Ljetnaveic/lcn30-drg2-dn40/files/renders/render_3d_southeast.png

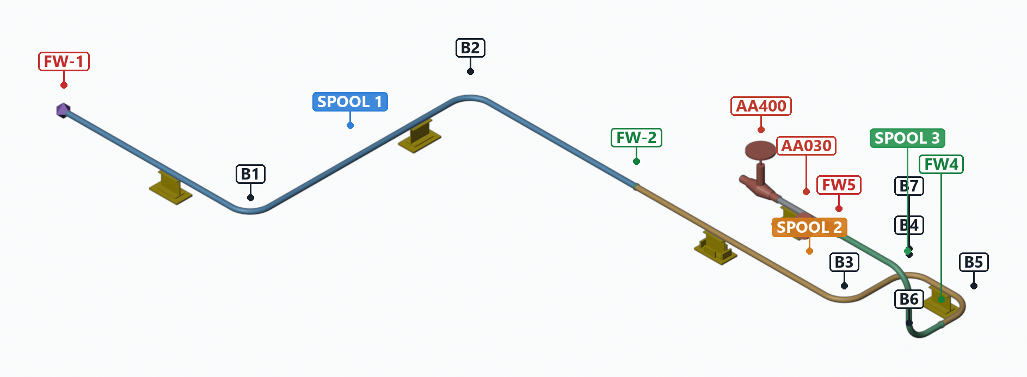
files/renders/render_3d_southeast.png
