Ljetnaveic/lcn30-drg2-dn40/files/renders/render_3d_southwest.png

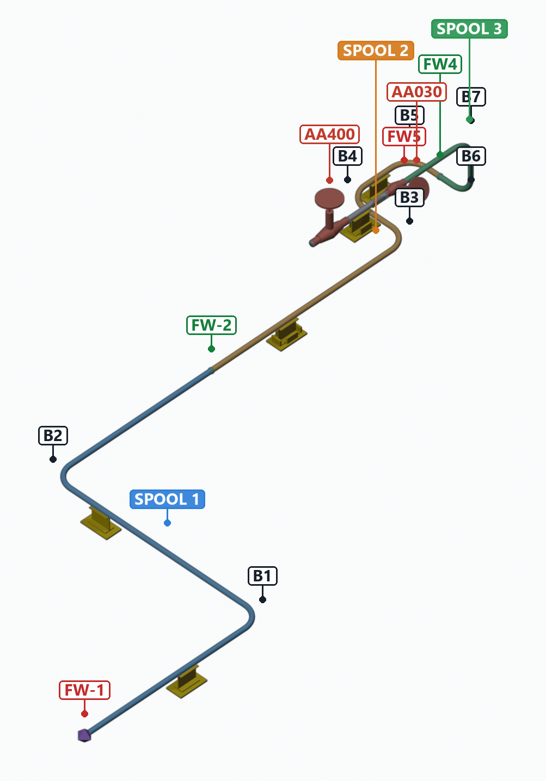
files/renders/render_3d_southwest.png
