Ljetnaveic/lcn30-drg2-dn40/files/renders/render_context_drg1.png

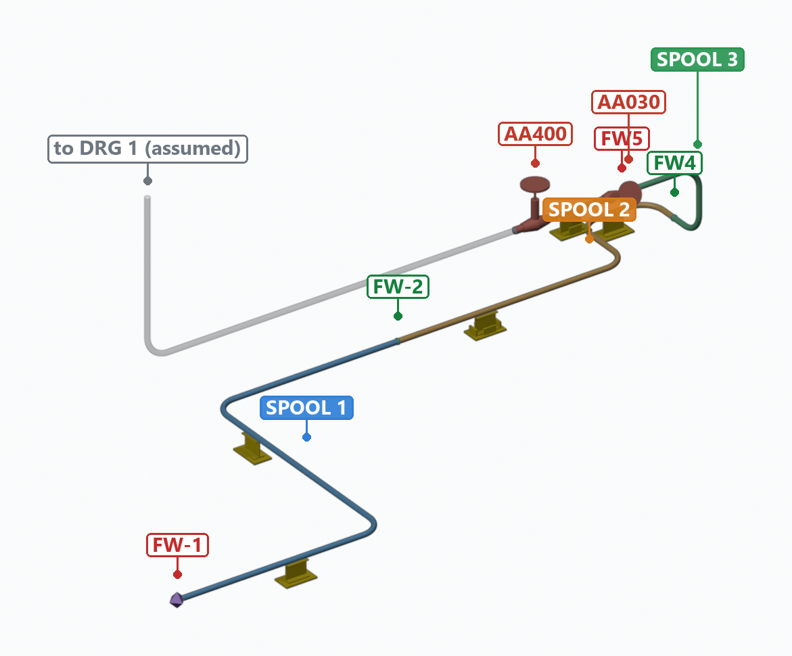
files/renders/render_context_drg1.png
