Ljetnaveic/lcn30-drg2-dn40/files/renders/render_plan_top.png

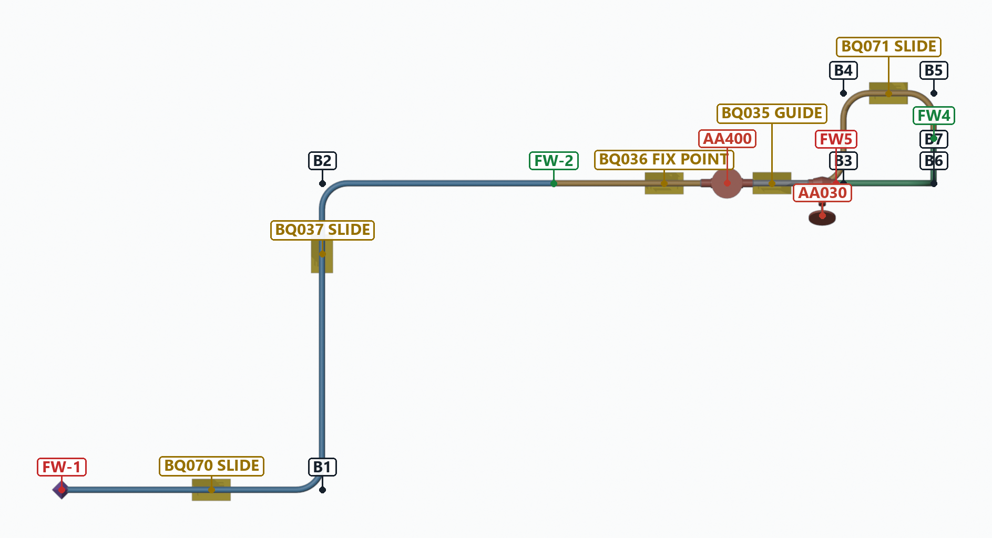
files/renders/render_plan_top.png
