Ljetnaveic/lcn30-drg2-dn40/files/renders/render_valves_loop.png

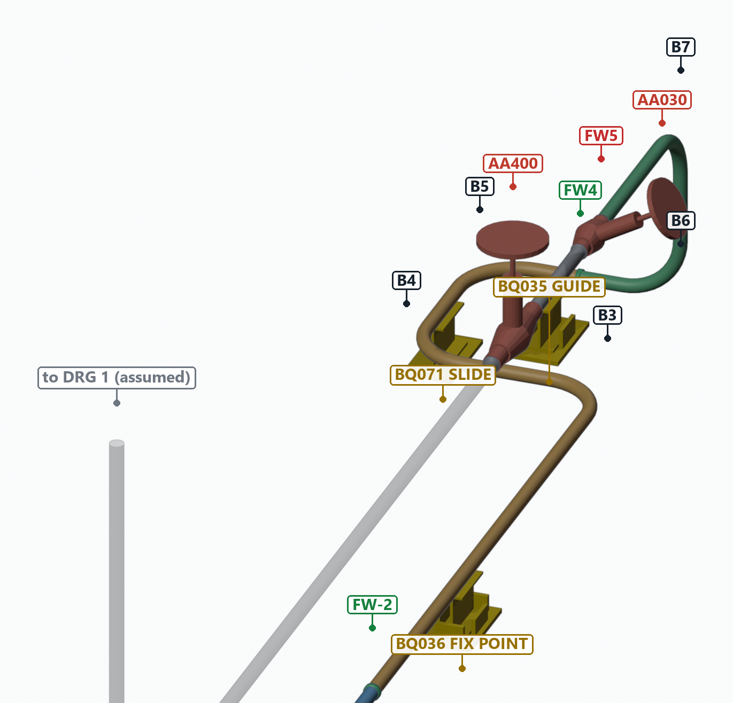
files/renders/render_valves_loop.png
