Ljetnaveic/lcn30-drg2-dn40/files/1LCN30_DRG2_DN40_BOM.csv

item | desc | qty | note
1 | Pipe DN40 (OD 48.3), class ECJB_TBY - spools 1-3 (developed) | 11.36 m | wall per class ECJB_TBY
2 | Pipe DN40 - piece between valves (iso ref <8>) | 0.44 m | 435 mm
3 | Pipe bend 90 deg, R = 200 mm (bent on pipe) | 7 pcs | B1-B7
4 | Valve 1LCN30AA030 (iso item 2), F-F 210, spindle H 60 deg | 1 pc | free issue / per valve list
5 | Valve 1LCN30AA400 (iso item 3), F-F 400, spindle H 0 deg, 30 deg BW ends | 1 pc | free issue / per valve list
6 | Support S4 SLIDE (BQ070, BQ037, BQ071) | 3 pcs | TC021-AFR-...-SU
7 | Support S4/7/6/6/6 FIX POINT (BQ036) | 1 pc | TC021-AFR-1LCN30BQ036-SU
8 | Support S4/5/6/6/6 GUIDE (BQ035) | 1 pc | TC021-AFR-1LCN30BQ035-SU
9 | Field welds FW-1, FW-2, FW4, FW5 (+ valve welds VW-1..3) | 4 + 3 | FW-2, FW4 welded
10 | Insulation 100 mm (density 0 per sheet) | 11.8 m | excl. valves
