Ljetnaveic/lcn30-drg2-dn40/files/1LCN30_DRG2_DN40_3D_Model.obj

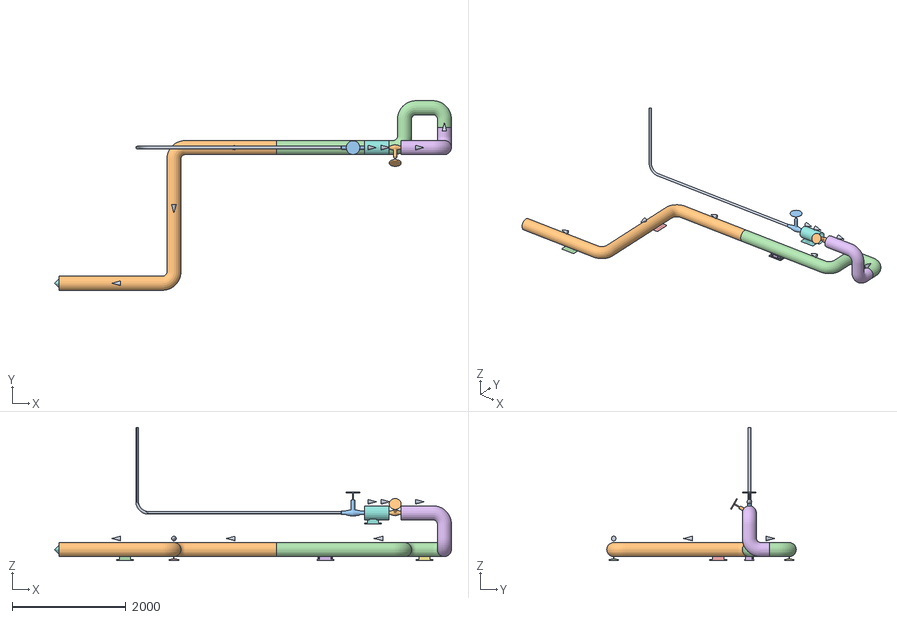
[picture p6: CAD file, 2026-11-06]
files/1LCN30_DRG2_DN40_3D_Model.obj
6971.1 x 3330.2 x 2338.1
PIPE_SPOOL_1
INSULATION_SPOOL_1
PIPE_SPOOL_2
INSULATION_SPOOL_2
PIPE_SPOOL_3
INSULATION_SPOOL_3
PIPE_ITEM_8
INSULATION_ITEM_8
DRG_1_CONTINUATION_(ASSUMED)
VALVE_1LCN30AA030
VALVE_1LCN30AA400
SUPPORT_1LCN30BQ070
SUPPORT_1LCN30BQ037
SUPPORT_1LCN30BQ036
SUPPORT_1LCN30BQ071
SUPPORT_1LCN30BQ035
WELD_FW-1
WELD_FW-2
WELD_FW4
WELD_FW5
WELD_VW-1
WELD_VW-2
WELD_VW-3
TIE-IN_0LCN50BR200
FLOW_DIRECTION
