Ljetnaveic/lcn30-drg2-dn40/(list of files, cad)

Other CAD files:
files/1LCN30_DRG2_DN40_2D_Drawings.dxf
files/1LCN30_DRG2_DN40_3D_Model.blend
files/1LCN30_DRG2_DN40_3D_Model.dxf
