Ljetnaveic/lcn30-drg2-dn40/files/1LCN30_DRG2_DN40_Drawing_Set.pdf

## 1LCN30 · DRG 2

DN40 condensate · class ECJB_TBY · P&ID 90207086

## Cover · 3D model in position

Plant coordinates X / Y / EL in mm

Sheet 1 of 12
06.11.2026 · reconstructed from site iso · not an issued drawing

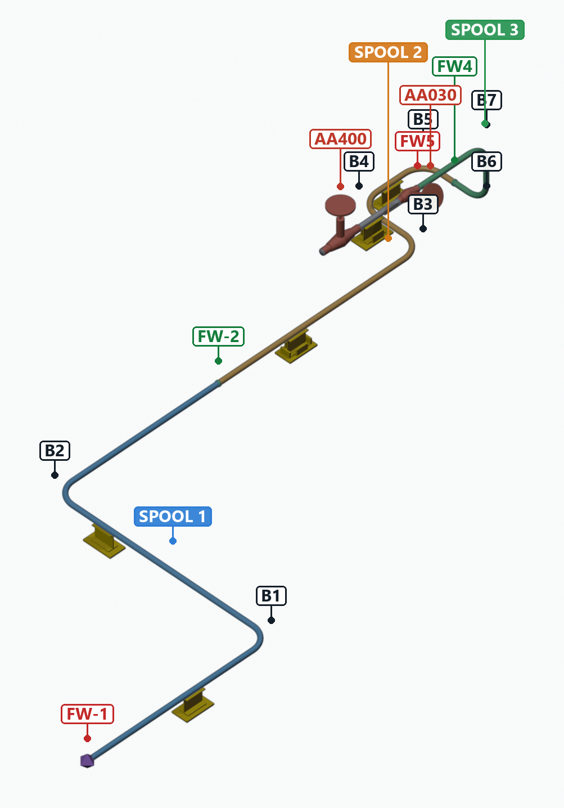
[picture p7: figure]

T H AME S I DE E R F ( T BY ) · P I P ING I S OME T R I C · R E C ONST R UC T E D 3 D / 2 D PAC K AG E

# 1LCN30 · DRG 2

DN40 condensate from DRG 1 through valves 1LCN30AA400 and 1LCN30AA030, down 645 mm into a horizontal expansion zig-zag at EL +4450, to the tie-in on 0LCN50BR200 (X 91628 · Y 82209 · EL +4450). Three bent-pipe spools, all bends 90° R 200.

### Spool 1

6 032 mm

FW-1 → FW-2 · 2 × 90° R200

### Spool 2

3 742 mm

FW-2 → FW4 · 3 × 90° R200

### Spool 3

1 583 mm

FW4 → FW5 · 2 × 90° R200

### Field welds

# 2 / 4 welded

FW-2 03.11.2026 · FW4 05.11.2026 · HC130

Medium | Condensate
Pipe class | ECJB_TBY
Nominal bore | DN40
Insulation thickness | 100 mm
Insulation density | 0 kg/m3
Fluid group / module | 2 / Module A
PED category | Category I
Design pressure | 96 bar(g)
Design temperature | 309 deg C
Operating pressure | 79.00 bar(g)
Operating temperature | 295 deg C
Test pressure | PT08.01 - 207.95 bar(g)
P&ID drawing | 90207086
Tie-in | 0LCN50BR200 at X 91628 / Y 82209 / EL +4450
Upstream | CONT. FROM DRG 1
Bend radius | 200 mm (all bends 90 deg)

Built from the site copy of the isometric with hand mark-up. Dimensions are theoretical PI-to-PI values; check on site before cutting (iso general remarks). Valve and support shapes are symbolic.

## 3D views

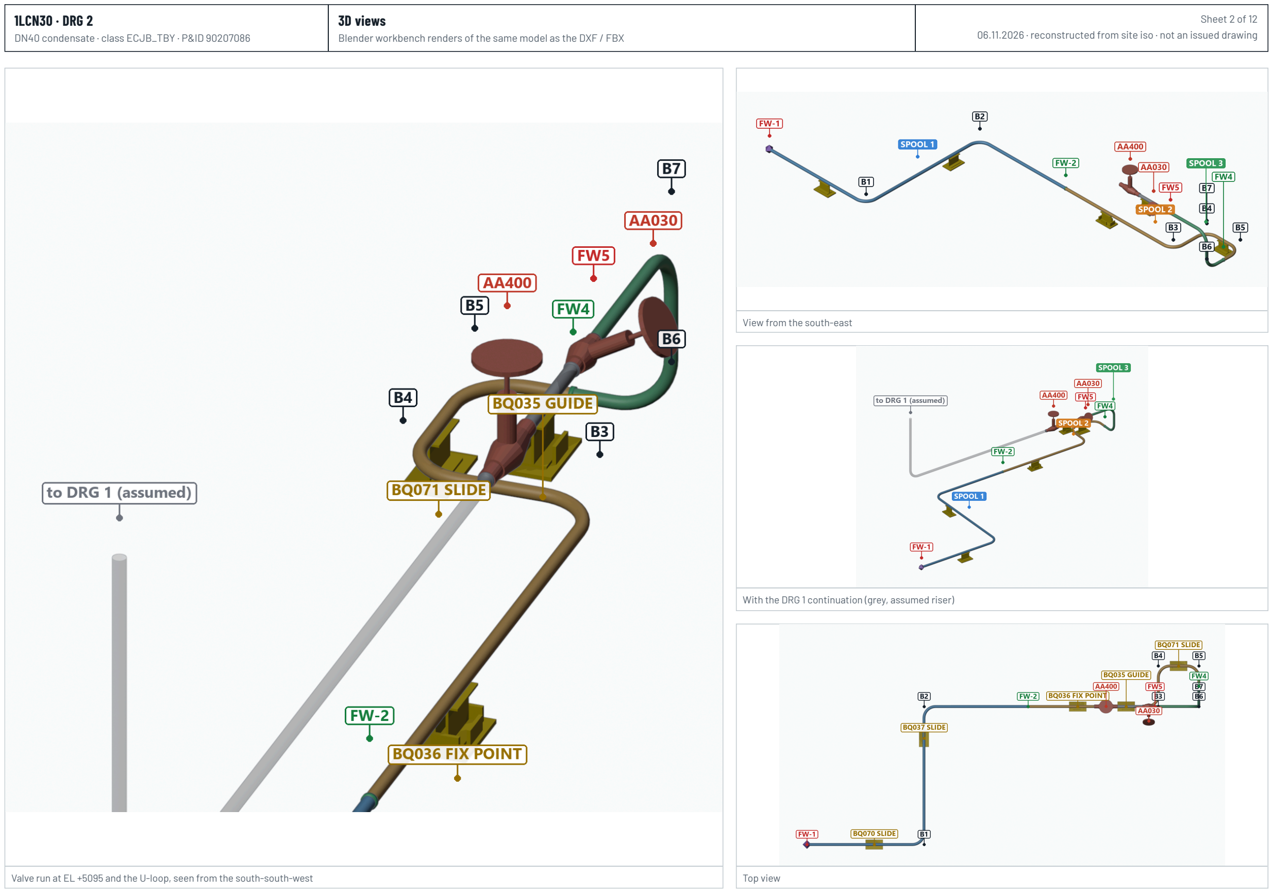
[picture p8: page 2]

Blender workbench renders of the same model as the DXF / FBX

Valve run at EL +5095 and the U-loop, seen from the south-south-west

View from the south-east

With the DRG 1 continuation (grey, assumed riser)

Top view

## PLAN VIEW - looking down (North up)

## 1LCN30BQ071 SLIDE

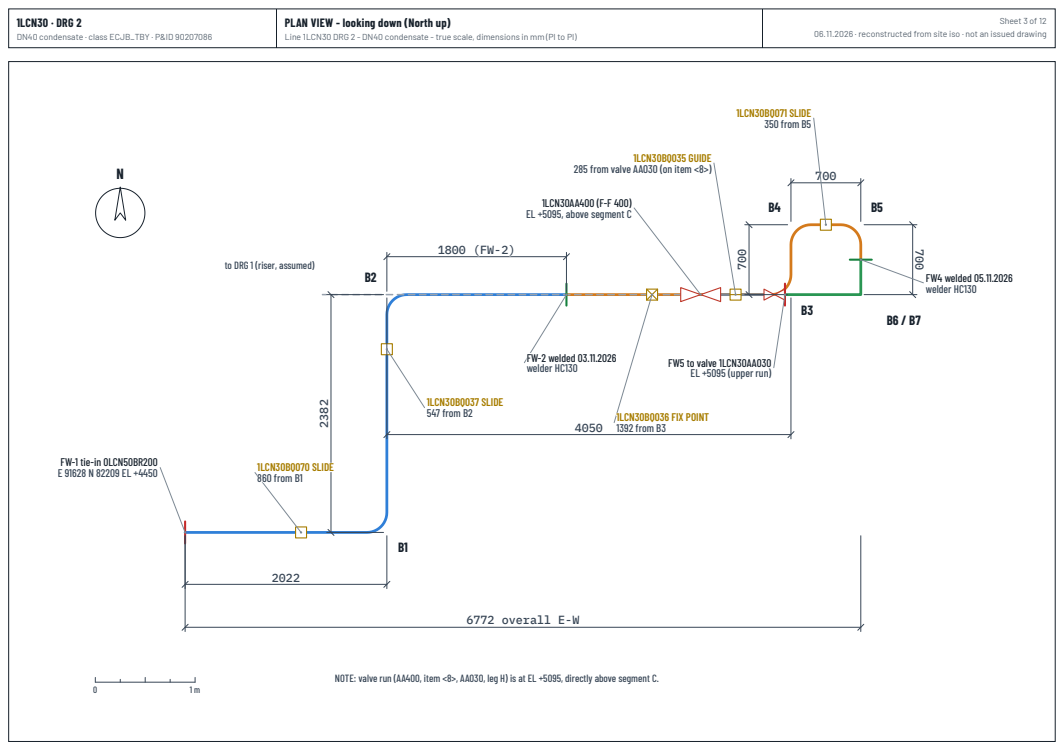
[picture p9: page 3]
6772 6772 overall E-W overall E-W; FW-2 welded 03.11.2026 welder HC130; FW4 welded 05.11.2026 welder HC130; 1LCN30BQ070 SLIDE 860 from B1; 1LCN30BQ037 SLIDE 547 from B2; 1LCN30BQ036 FIX POINT 1392 from B3; 350 from B5; 1LCN30BQ035 GUIDE

Line 1LCN30 DRG 2 - DN40 condensate - true scale, dimensions in mm (PI to PI)

285 from valve AA030 (on item <8>)

11LLCCNN3300AAAA440000 ((FF--FF 440000))
EL +5095, above segment C

to DRG 1 (riser, assumed)

FW5 to valve 1LCN30AA030
EL +5095 (upper run)

FW-1 tie-in 0LCN50BR200
EE 9911662288 NN 8822220099 EELL ++44445500

NOTE: valve run (AA400, item <8>, AA030, leg H) is at EL +5095, directly above segment C.

## ELEVATION A - looking North (from South)

11LLCCNN3300AAAA440000 ssppiinnddllee HH 00 | 11LLCCNN3300AAAA003300 ssppiinnddllee HH 6600

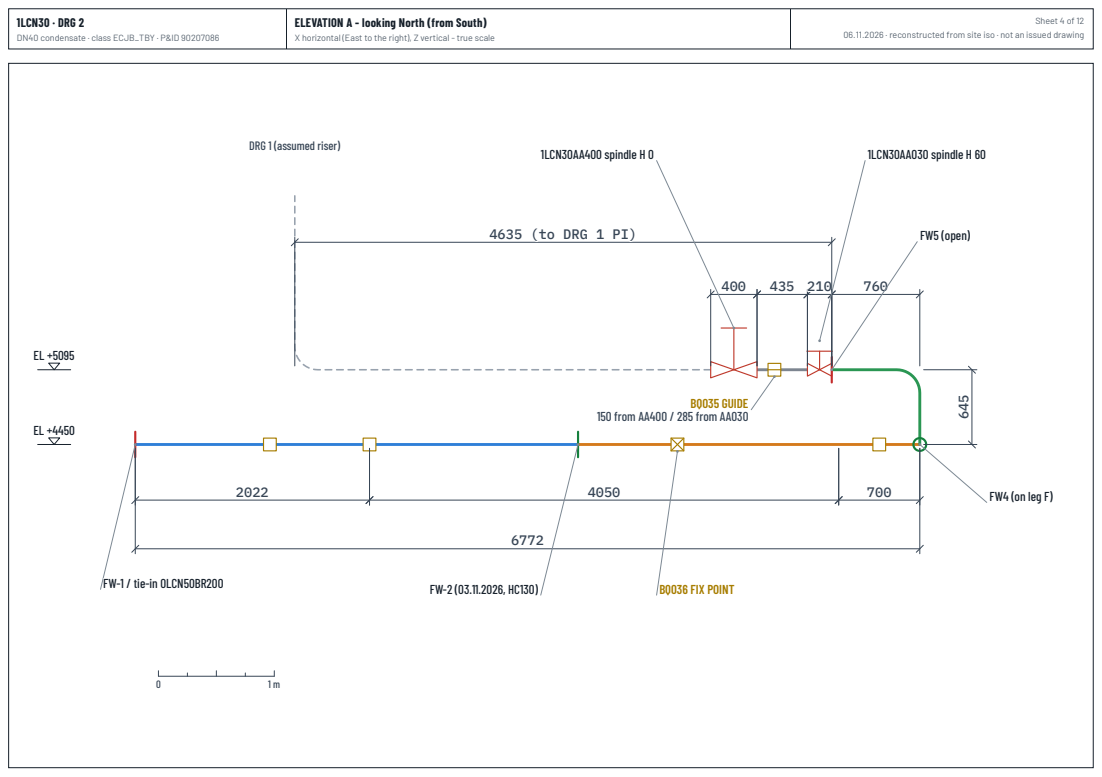
[picture p10: page 4]
EELL ++44445500; EELL ++55009955; FFWW--22 ((0033..1111..22002266,, HHCC113300)); FFWW55 ((ooppeenn)); BQBQ003366 FFIIXX PPOOIINNTT; BQBQ003355 GUGUIIDDEE 115500 ffrroomm AAAA440000 // 228855 ffrroomm AAAA003300

X horizontal (East to the right), Z vertical - true scale

DRG 1 (assumed riser)

4635 (to DRG 1 PI)

FW4 (on leg F)

FW-1 / tie-in 0LCN50BR200

## ELEVATION B - looking West (from East)

# DRG 1 (assumed riser)

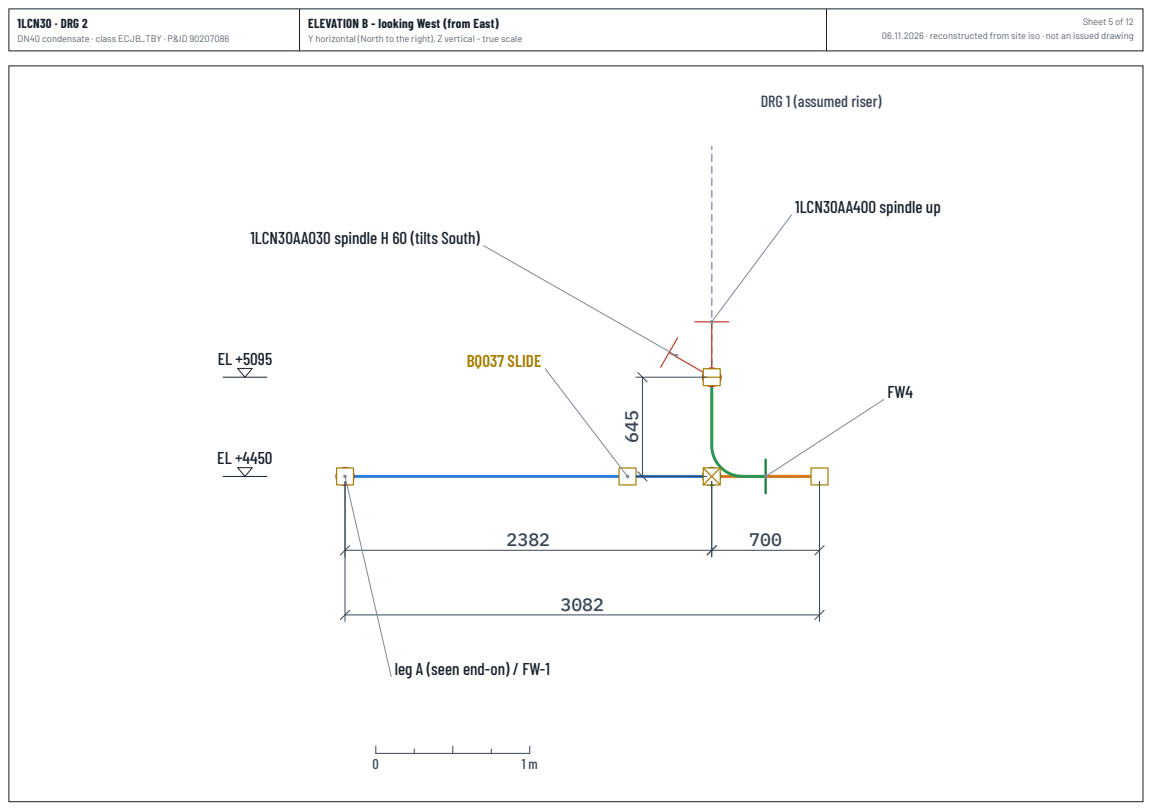
[picture p11: page 5]
ELEL ++44445050; ELEL ++50509955; BBQQ0037 37 SLSLIIDDEE; 11LLCCNN3030AAA4A40000 ssppiindndllee upup

Y horizontal (North to the right), Z vertical - true scale

11LLCCNN3030AAA0A03030 ssppiindndllee HH 6060 ((ttiillttss SoSouutthh))

lleegg A A ((sseeeen n eendnd--on) on) // FFWW--11

## 3D VIEW - axonometric from South-West (true scale)

## SSPPOOOOLL 33

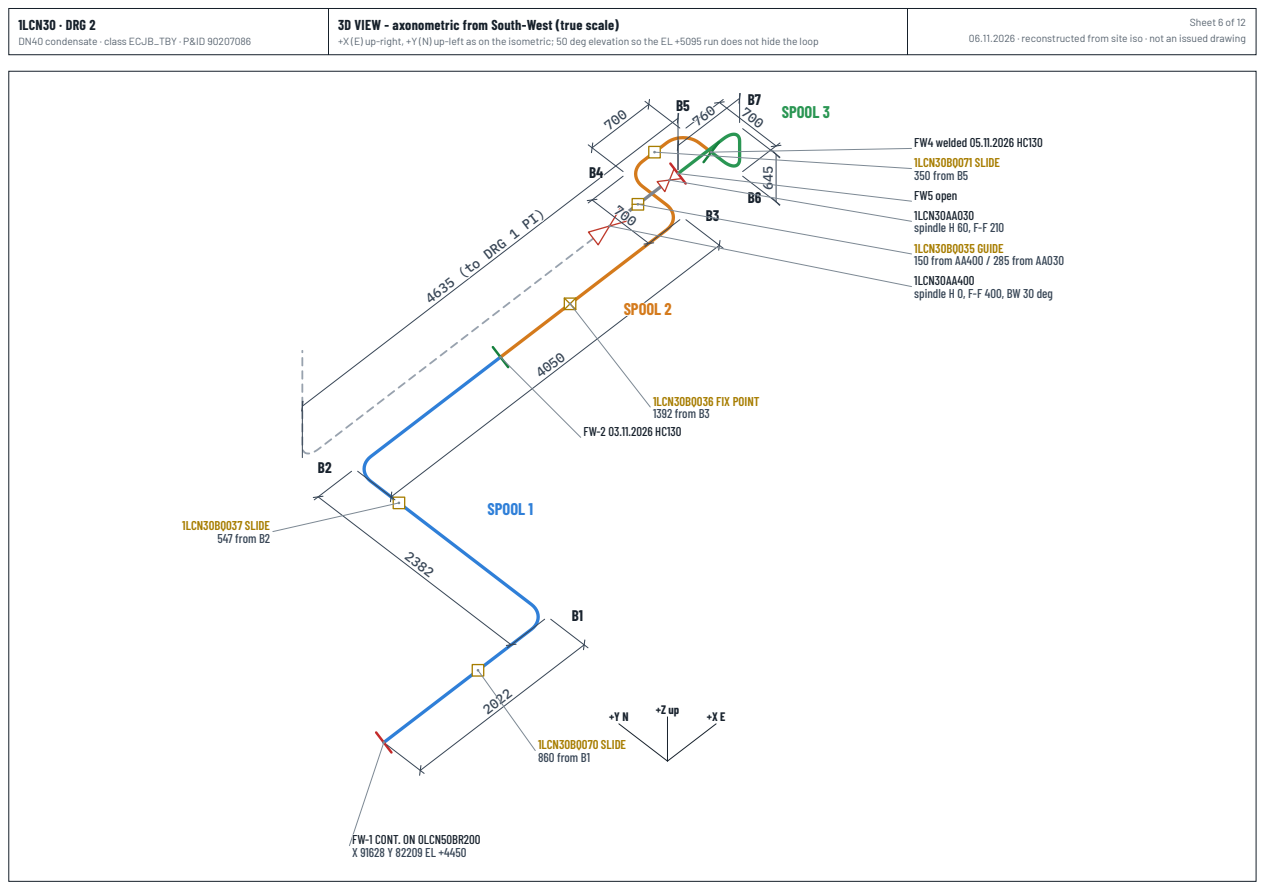
[picture p12: page 6]
DRG 1 PI); SPOOL 1; SPOOL 2; FW-2 03.11.2026 HC130; 1LCN30BQ070 SLIDE 860 from B1; 1LCN30BQ037 SLIDE 547 from B2; 1LCN30BQ036 FIX POINT 1392 from B3

+X (E) up-right, +Y (N) up-left as on the isometric; 50 deg elevation so the EL +5095 run does not hide the loop

FW4 welded 05.11.2026 HC130
1LCN30BQ071 SLIDE
335500 ffrroomm BB55
FW5 open
11LLCCNN3300AAAA003300
ssppiinnddllee HH 6600,, FF--FF 221100
1LCN30BQ035 GUIDE
115500 ffrroomm AAAA440000 // 228855 ffrroomm AAAA003300
11LLCCNN3300AAAA440000
spindle H 0, F-F 400, BW 30 deg

4635 (to DRG 1 PI)

FW-1 CONT. ON 0LCN50BR200
XX 9911662288 YY 8822220099 EELL ++44445500

## SPOOL 1 - FW-1 to FW-2

### FW-2 welded 03.11.2026 HC130

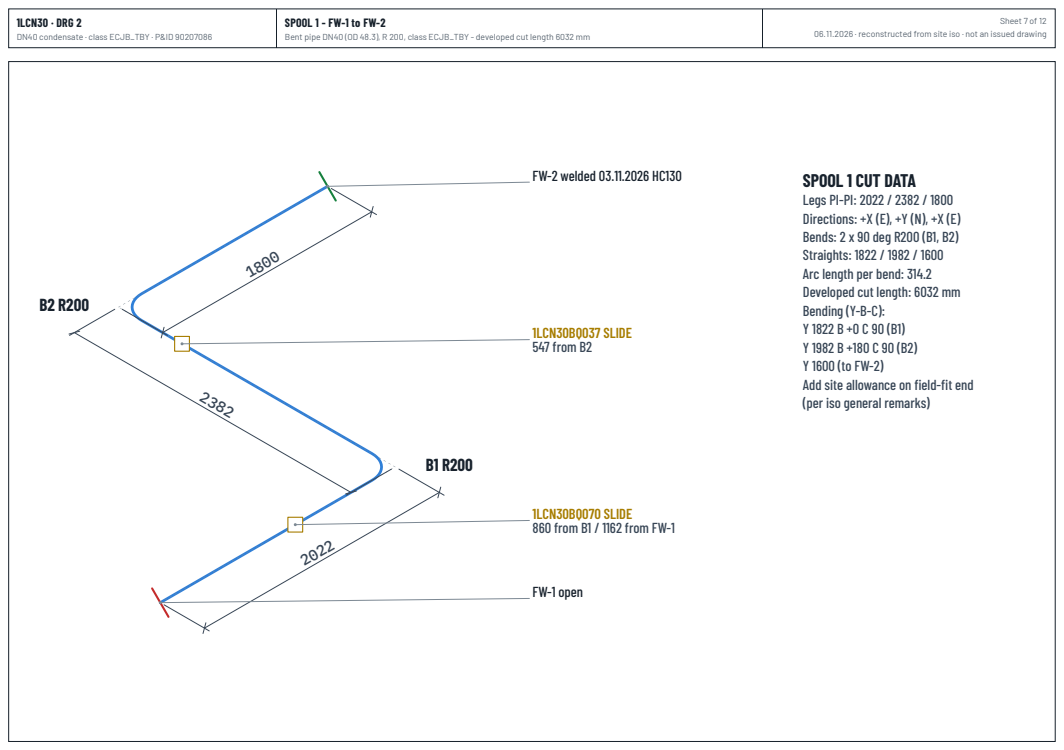
[picture p13: page 7]
11LLCCNN3300BBQ0Q03377 SLIDE 547 from B2; FW-1 open

Bent pipe DN40 (OD 48.3), R 200, class ECJB_TBY - developed cut length 6032 mm

SPOOL 1 CUT DATA
LLeeggss PPI-I-PPI:I: 22002222 // 22338822 // 11880000
DDiirreeccttiioonnss:: +X+X ((EE)),, +Y+Y ((NN)),, +X+X ((EE))
Bends: 2 x 90 deg R200 (B1, B2)
SSttrraaiigghhttss:: 11882222 // 11998822 // 11660000
Arc length per bend: 33114. 4.2
DDeevveellooppeedd ccuutt lleennggtthh:: 66003322 mmmm
BBeennddiinngg ((YY--BB--CC))::
Y 1600 (to FW-2)
AAdddd ssiittee aalllloowwaannccee oonn fifieelldd--fifitt eenndd
(per iso general remarks)

11LLCCNN3300BBQ0Q07700 SLIDE
860 from B1 / 1162 from FW-1

## SPOOL 2 - FW-2 to FW4

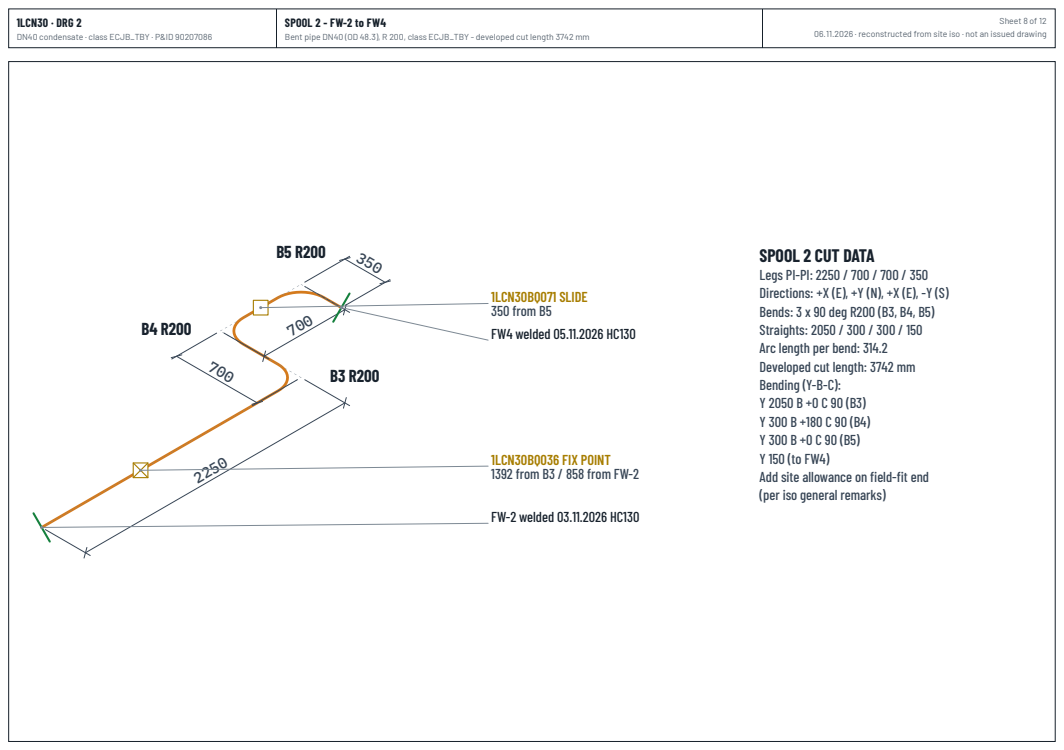
[picture p14: page 8]
11LLCCN3N300BBQ0Q07711 SSLLIIDDEE 335500 ffrroomm BB55 FFWW44 wweellddeedd 0055..1111..22002266 HCHC113300; FFWW--22 wweellddeedd 0033..1111..22002266 HCHC113300

Bent pipe DN40 (OD 48.3), R 200, class ECJB_TBY - developed cut length 3742 mm

SPOOL 2 CUT DATA
LLeeggss PI PI--PI PI:: 22225500 // 770000 // 770000 // 335500
DDiirreeccttiioonnss:: ++XX ((EE)),, ++YY ((NN)),, ++XX ((EE)),, --YY ((SS))
Bends: 3 x 90 deg R200 (B3, B4, B5)
SSttrraaiigghhttss:: 22005500 // 330000 // 330000 // 115500
Arc length per bend: 314.2
DDeevveellooppeedd ccuutt lleennggtthh:: 33774422 mmmm
BBeennddiinngg ((YY--BB--CC))::
Y 150 (to FW4)
Add site allowance on fiefielldd--fit fit end
(per iso general remarks)

11LLCCN3N300BBQ0Q03366 FFIIXX PPOOIINTNT
1392 from B3 / 858 from FW-2

## SPOOL 3 - FW4 to FW5

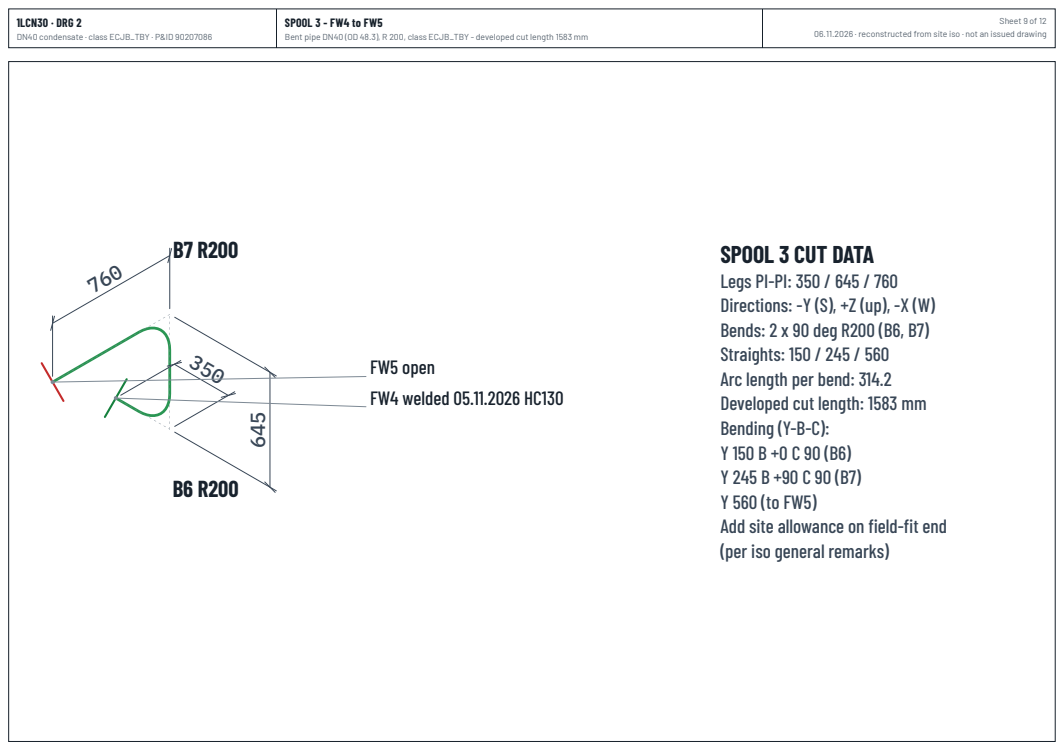
[picture p15: page 9]
FW5 open; FW4 welded 05.11.2026 HC130

Bent pipe DN40 (OD 48.3), R 200, class ECJB_TBY - developed cut length 1583 mm

SPOOL 3 CUT DATA
Legs PI-PI: 350 / 645 / 760
DDiirreeccttiioonsns:: --YY ((SS)),, ++ZZ ((up) up),,
BBeendndss:: 22 xx 9900 ddeegg RR220000 ((BB66,, BB77))
SSttrraaiigght htss:: 115500 // 224455 // 556600
AArrcc lleengngtth h ppeerr bbeendnd:: 331144..22
DDeevveellooppeedd ccut ut lleengngtth: h: 11558383 mmmm
BBeendndiingng ((YY--BB--CC))::
Y 560 (to FW5)
AAdddd ssiittee aalllloowwaancncee oon n fifieelldd--fifitt eenndd
((ppeerr iissoo ggeenenerraall rreemmaarrkkss))

## Fabrication · spools and cut lengths

Developed length = legs − 2 × 200 tangent + 314.2 arc per bend · Y-B-C: + = clockwise looking along the feed

## Spool 1 · FW-1 → FW-2

6032.3 mm developed cut length

LEG | PI–PI | STRAIGHT | DIRECTION
A | 2 022 | 1 822 +X (E)
B | 2 382 | 1 982 +Y (N)
C | 1 800 | 1 600 +X (E)

Bends B1, B2: 90°, R 200, arc 314.2 each. PI sum 6 204.
Y 1 822 / B +0° / C 90° · Y 1 982 / B +180° / C 90° · Y 1 600 From E 91628 / N 82209 / EL +4450
to E 95450 / N 84591 / EL +4450

## Spool 2 · FW-2 → FW4

3742.5 mm developed cut length

LEG | PI–PI | STRAIGHT | DIRECTION
A | 2 250 | 2 050 +X (E)
B | 700 | 300 +Y (N)
C | 700 | 300 +X (E)
D | 350 | 150 -Y (S)

Bends B3, B4, B5: 90°, R 200, arc 314.2 each. PI sum 4 000.
Y 2 050 / B +0° / C 90° · Y 300 / B +180° / C 90° · Y 300 / B +0° / C 90° · Y 150
From E 95450 / N 84591 / EL +4450
to E 98400 / N 84941 / EL +4450

## Spool 3 · FW4 → FW5

1583.3 mm developed cut length

LEG | PI–PI | STRAIGHT | DIRECTION
A | 350 | 150 -Y (S)
B | 645 | 245 +Z (up)
C | 760 | 560 -X (W)

Bends B6, B7: 90°, R 200, arc 314.2 each. PI sum 1 755.
Y 150 / B +0° / C 90° · Y 245 / B +90° / C 90° · Y 560 From E 98400 / N 84941 / EL +4450
to E 97640 / N 84591 / EL +5095

## Bend tangent points (plant coordinates X / Y / EL)

BEND | ANGLE | TANGENT | TP1 | TP2 | CENTRE
B1 | 90.0° | 200.0 93 450 / 82 209 / 4 450 | 93 650 / 82 409 / 4 450 | 93 450 / 82 409 / 4 450
B2 | 90.0° | 200.0 93 650 / 84 391 / 4 450 | 93 850 / 84 591 / 4 450 | 93 850 / 84 391 / 4 450
B3 | 90.0° | 200.0 97 500 / 84 591 / 4 450 | 97 700 / 84 791 / 4 450 | 97 500 / 84 791 / 4 450
B4 | 90.0° | 200.0 97 700 / 85 091 / 4 450 | 97 900 / 85 291 / 4 450 | 97 900 / 85 091 / 4 450
B5 | 90.0° | 200.0 98 200 / 85 291 / 4 450 | 98 400 / 85 091 / 4 450 | 98 200 / 85 091 / 4 450
B6 | 90.0° | 200.0 98 400 / 84 791 / 4 450 | 98 400 / 84 591 / 4 650 | 98 400 / 84 791 / 4 650
B7 | 90.0° | 200.0 98 400 / 84 591 / 4 895 | 98 200 / 84 591 / 5 095 | 98 200 / 84 591 / 4 895

## Coordinates, welds, supports, material

## Route points

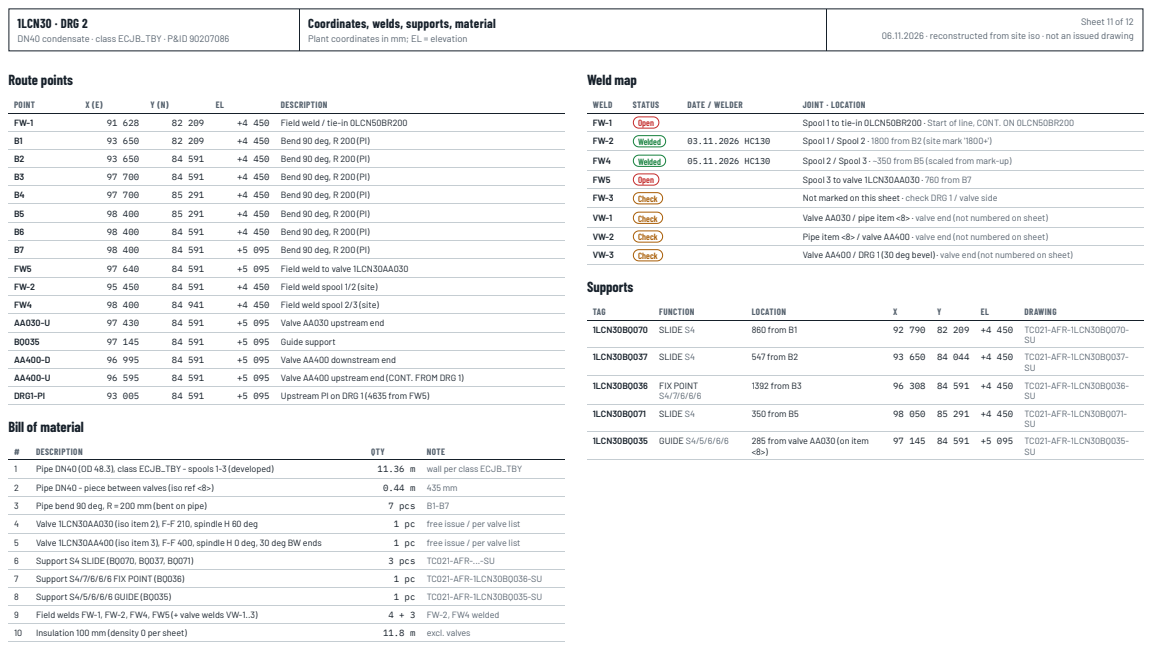
[picture p16: page 11]
POINT; DESCRIPTION; +4 450 Field weld / tie-in 0LCN50BR200; +4 450 Bend 90 deg, R 200 (PI); +5 095 Bend 90 deg, R 200 (PI); +5 095 Field weld to valve 1LCN30AA030; +4 450 Field weld spool 1/2 (site); +4 450 Field weld spool 2/3 (site); +5 095 Valve AA030 upstream end; +5 095 Guide support; +5 095 Valve AA400 downstream end; +5 095 Valve AA400 upstream end (CONT. FROM DRG 1); DRG1-PI; +5 095 Upstream PI on DRG 1 (4635 from FW5); QTY; NOTE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

Plant coordinates in mm; EL = elevation

Bill of material

## Assumptions and loading instructions

Read before use

## What was read and what was assumed

1. Orientation from the axis legend in the iso title block: +X drawn up-right, +Y up-left. Confirm with the north arrow on the issued iso; if it differs, rotate about FW-1.
2. Start point is the iso tie-in: X 91628 · Y 82209 · EL +4450 (0LCN50BR200).
3. Leg G rises 645, so the valve run is at EL +5095, directly above segment C.
4. FW-2 taken as 1800 from B2 from the site mark "1800+". FW4 scaled from the mark-up at about 350 from B5. Measure both on site.
5. FW-3 is not marked on this sheet. VW-1 to VW-3 (valve welds) are numbered here for reference only.
6. Valve and support geometry is symbolic. Real sizes: valve list and TC021-AFR-…-SU support drawings. Pipe OD 48.3 (DN40); wall per class ECJB_TBY.
7. Beyond valve AA400 the line continues on DRG 1 (4635 from FW5 to the next PI). The riser there is assumed from the 3D print.
8. Weld status from the hand mark-up: FW-2 welded 03.11.2026 and FW4 welded 05.11.2026, both welder HC130. FW-1 and FW5 have no record on the sheet.

## Loading the model

1. Navisworks Manage / Simulate: open the plant model, Home › Append › 1LCN30_DRG2_DN40_3D_Model.dxf (units mm) or the .fbx. It lands at its real X / Y / EL.
2. Navisworks Freedom opens NWD only and cannot append. A Manage user appends and saves an NWD; Freedom then opens it.
3. AutoCAD / Plant 3D / BricsCAD: open the 3D DXF in model space (WCS = plant coordinates). Layers: PIPE-SPOOL1..3, PIPE-ITEM8, INSULATION, VALVES, SUPPORTS, WELDS-DONE / OPEN / VALVE, CENTERLINE, LABELS, DRG1-CONTEXT. The 2D DXF holds all seven sheets.
4. Interactive viewer: 1LCN30_DRG2_DN40_Viewer.html opens in any browser (internet needed for the 3D library): orbit, click for properties, measure, plant coordinates under the cursor.

## Package

…_Drawing_Set.pdf | this document
…_3D_Model.dxf / .fbx / .obj / .blend | 3D model, plant coordinates mm, Z up
…_2D_Drawings.dxf | seven 2D sheets
…_Viewer.html | interactive 3D / 2D viewer
…_*.csv | coordinates, spools, welds, supports, BOM
renders/*.png | 3D images
